Jan-IngenHousz-Institute/CO2Dot/Kicad/CO2Dot_v001/CO2Dot.png

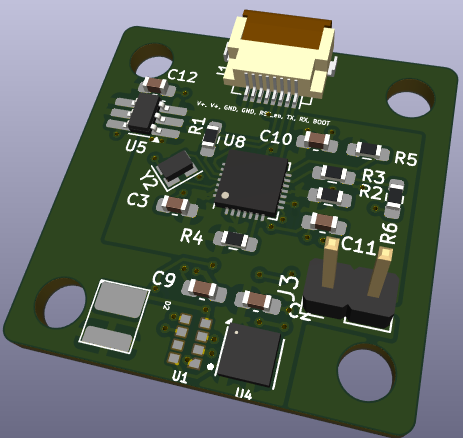
Kicad/CO2Dot_v001/CO2Dot.png
