Jan-IngenHousz-Institute/CO2Dot/Firmware/README.md

# firmware-CO2Dot
Repo for the firmware of the CO2Dot
