Jan-IngenHousz-Institute/CO2Dot/Scripts/Li-Control/README.md

This repository is a lightweight LI‑6800 control based on mqtt capability of the instrument.
