Jan-IngenHousz-Institute/CO2Dot/CAD/leaf_cells/chamber_CO2Dot_openExit.FCStd

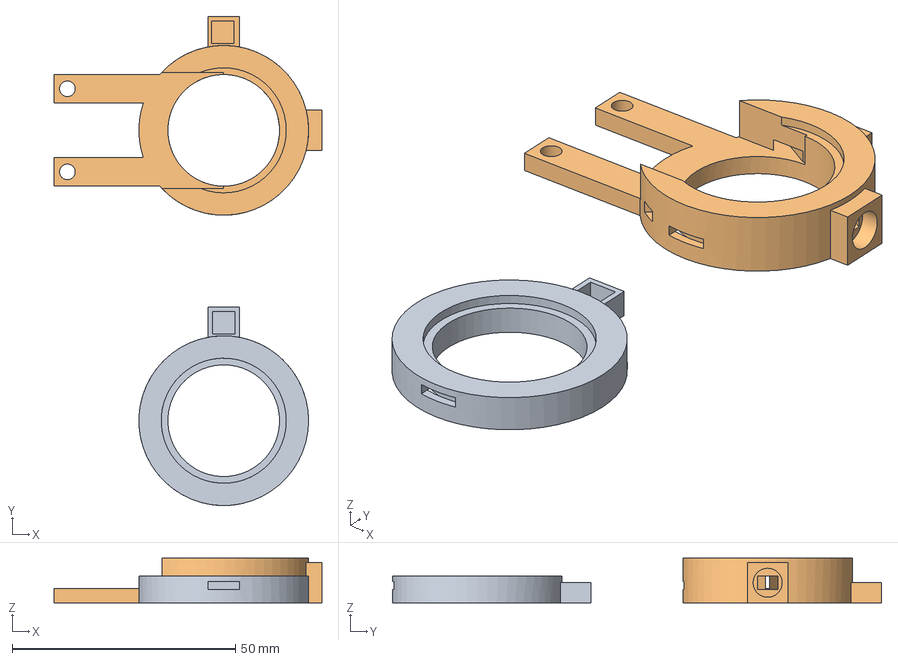
[picture p2: CAD file, 2026-07-20]
CAD/leaf_cells/chamber_CO2Dot_openExit.FCStd
60.0 x 109.5 x 10.0 mm
