Jan-IngenHousz-Institute/CO2Dot/CAD/Licor_cellAdapter.FCStd

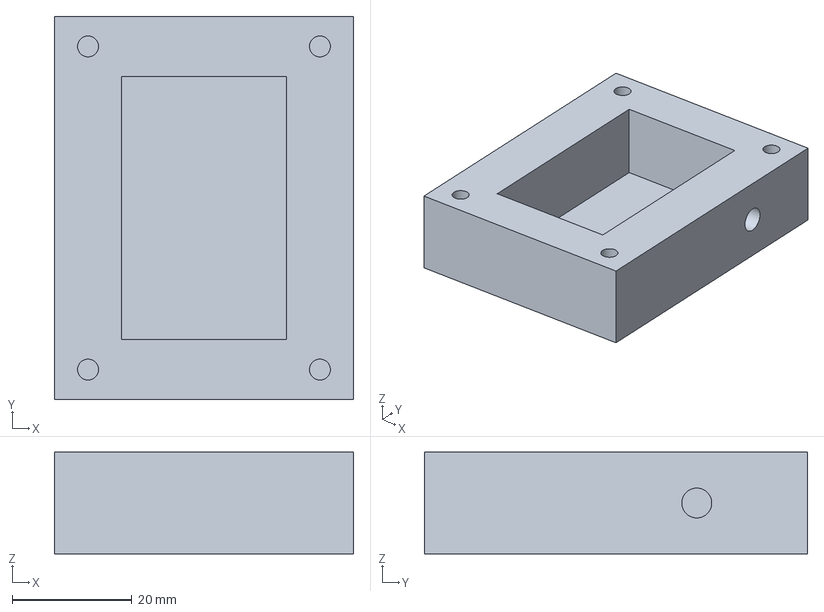
[picture p3: CAD file, 2026-11-12]
CAD/Licor_cellAdapter.FCStd
50.0 x 64.0 x 17.0 mm
