Jan-IngenHousz-Institute/CO2Dot/CAD/CO2Dot_holder_v003.FCStd

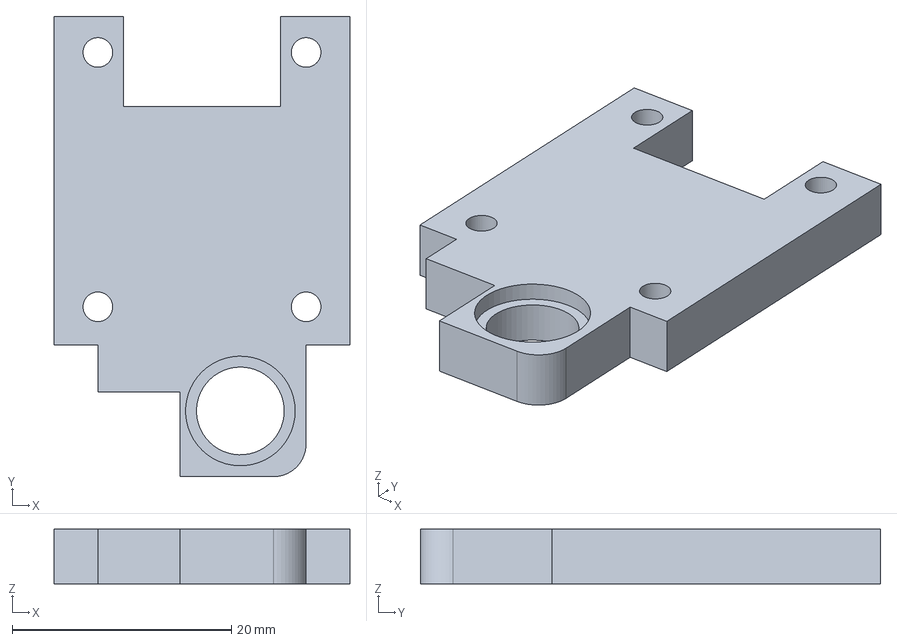
[picture p4: CAD file, 2026-10-07]
CAD/CO2Dot_holder_v003.FCStd
27.0 x 42.0 x 5.00 mm
