Jan-IngenHousz-Institute/CO2Dot/CAD/leaf_cells/chamber_CO2DOt_tubingExit.FCStd

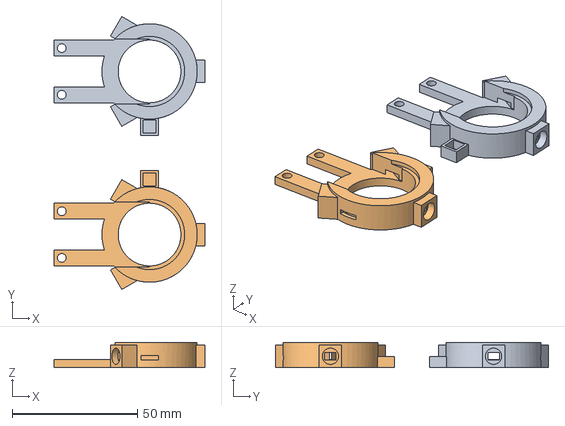
[picture p5: CAD file, 2026-07-20]
CAD/leaf_cells/chamber_CO2DOt_tubingExit.FCStd
60.0 x 108.8 x 10.0 mm
