Jan-IngenHousz-Institute/CO2Dot/CAD/CO2Dot_diffuserHolder.FCStd

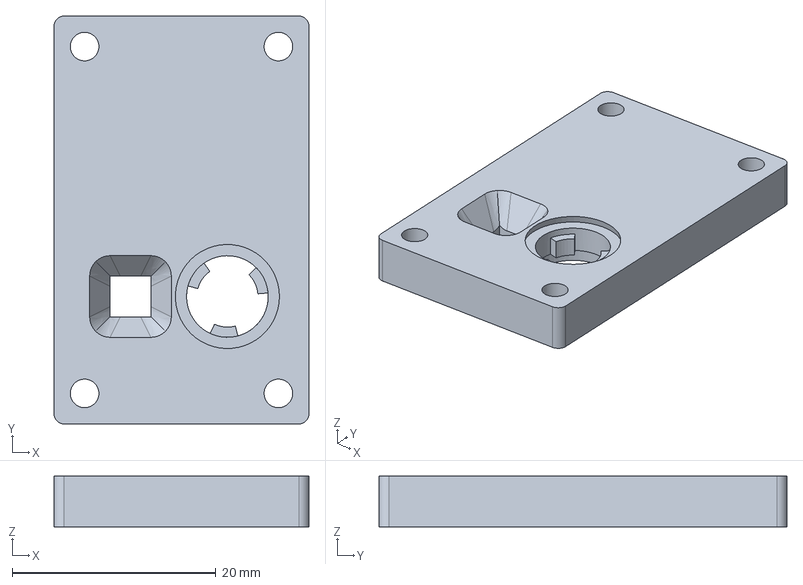
[picture p6: CAD file, 2026-06-19]
CAD/CO2Dot_diffuserHolder.FCStd
25.0 x 40.0 x 5.00 mm
