Jan-IngenHousz-Institute/CO2Dot/CAD/leaf_cells/CO2Dot_mask.3mf

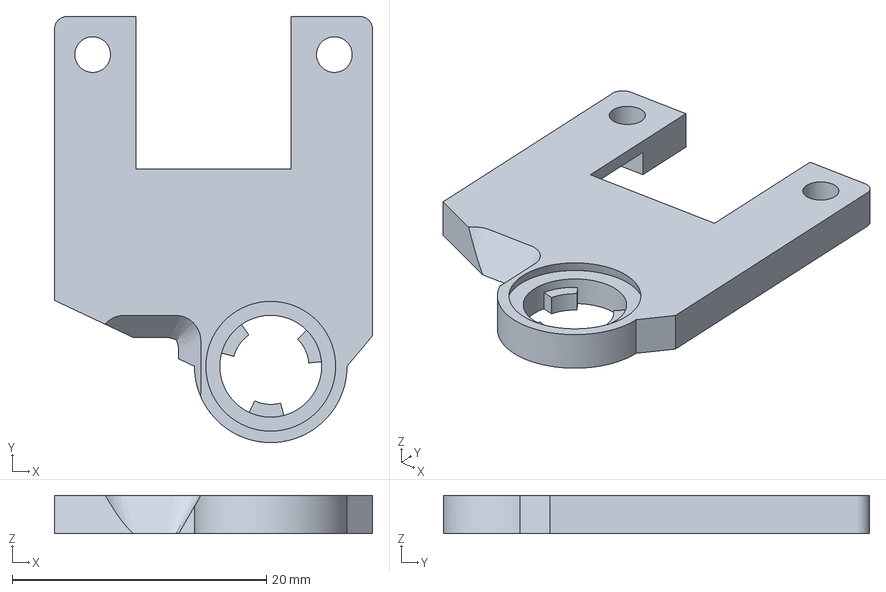
[picture p7: CAD file, 2026-07-20]
CAD/leaf_cells/CO2Dot_mask.3mf
25.0 x 33.5 x 3.00 mm
