Jan-IngenHousz-Institute/CO2Dot/CAD/gasCell_CO2Dot_v1.FCStd

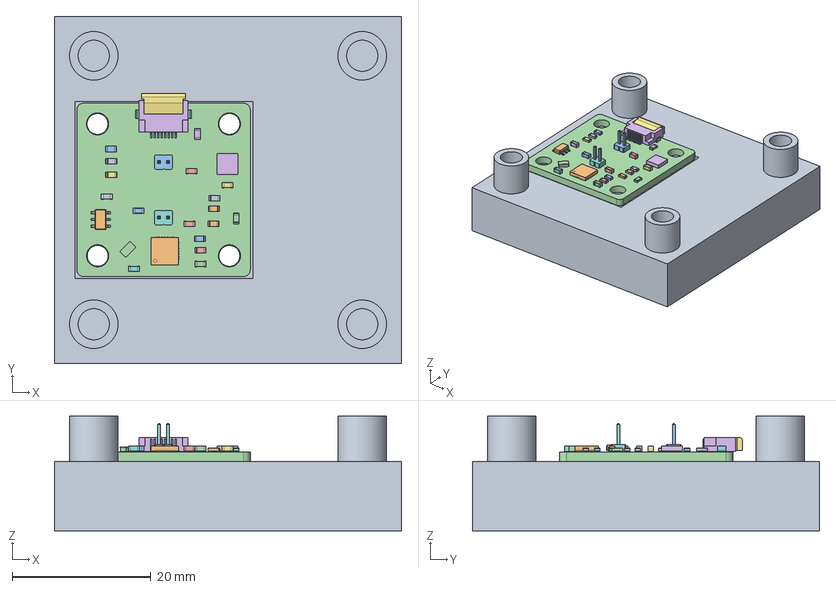
[picture p8: CAD file, 2026-05-03]
CAD/gasCell_CO2Dot_v1.FCStd
50.0 x 50.0 x 16.5 mm
CO2Dot_base
TSOT-23-6
R_0603_1608Metric
R_0603_1608Metric001
C_0603_1608Metric
R_0603_1608Metric002
R_0603_1608Metric003
C_0603_1608Metric001
C_0603_1608Metric002
QFN-28-1EP_4x4mm_P0.4mm_EP2.4x2.4mm
R_0603_1608Metric004
C_0603_1608Metric003
R_0603_1608Metric005
lock
pins
R_0603_1608Metric006
R_0603_1608Metric007
PinHeader_1x02_P1.27mm_Vertical
Crystal_SMD_MicroCrystal_CC8V-T1A-2Pin_2.0x1.2mm
C_0603_1608Metric004
Bosch_LGA-8_3x3mm_P0.8mm_ClockwisePinNumbering
C_0603_1608Metric005
PinHeader_1x02_P1.27mm_Vertical001
R_0603_1608Metric008
R_0603_1608Metric009
C_0603_1608Metric006
ambit_dyeCO2_PCB
