Jan-IngenHousz-Institute/CO2Dot/CAD/leaf_cells/mold_gasket.FCStd

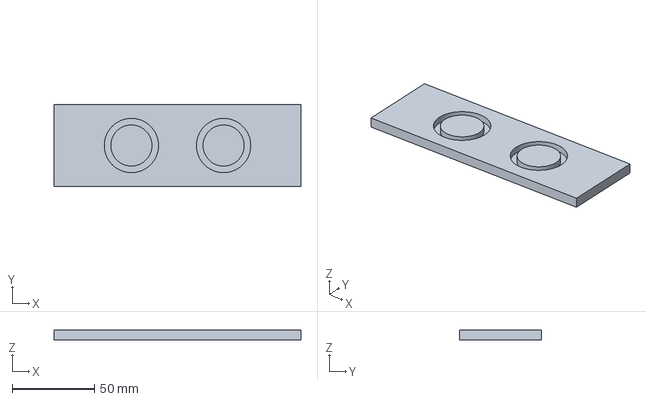
[picture p9: CAD file, 2026-07-20]
CAD/leaf_cells/mold_gasket.FCStd
150.0 x 50.0 x 6.00 mm
