Jan-IngenHousz-Institute/CO2Dot/CAD/leaf_cells/attachment_chamber_clip.FCStd

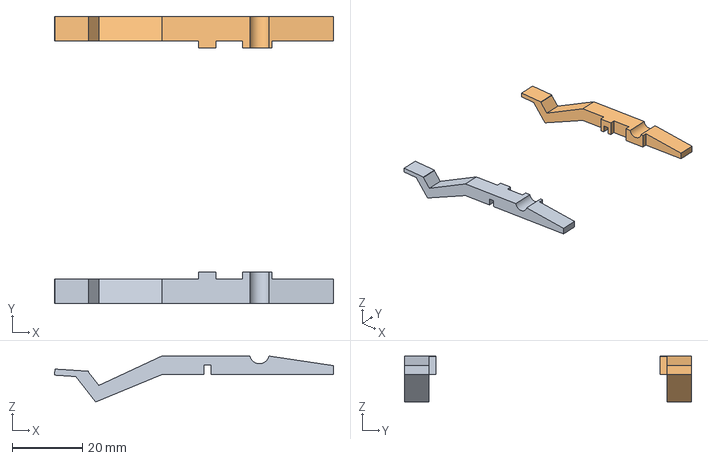
[picture p10: CAD file, 2026-07-20]
CAD/leaf_cells/attachment_chamber_clip.FCStd
79.6 x 82.0 x 13.1 mm
