Jan-IngenHousz-Institute/CO2Dot/(list of files, cad)

Other CAD files:
CAD/leaf_cells/CO2Dot_mask.stl
