Jan-IngenHousz-Institute/CO2Dot/Kicad/CO2Dot.kicad_pcb

## KiCad design Kicad/CO2Dot.kicad_pcb (2026-09-03)

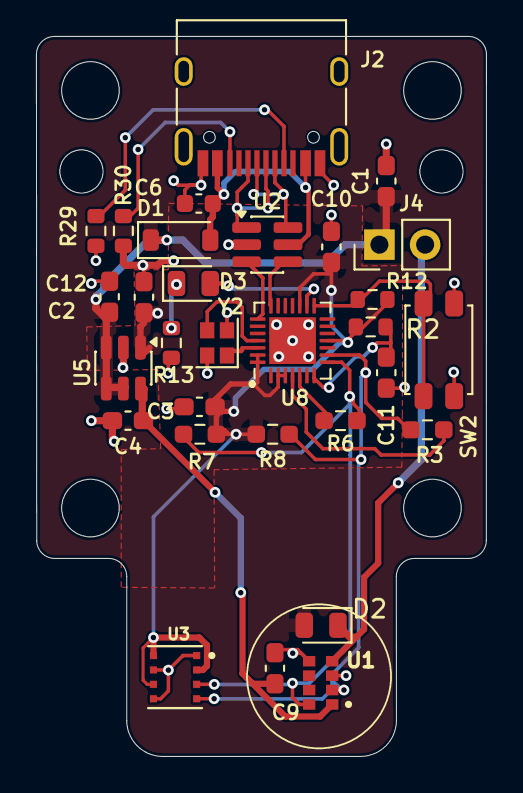
[picture p11: board Kicad/CO2Dot.kicad_pcb from above]

Board: 4 copper layers, 25.0 x 40.0 mm, 30 parts (0 on the bottom side), 22 nets.

Parts:
C1, C2, C3, C4, C9, C10, C11, C12: 2.2u; C_0603_1608Metric_Pad1.08x0.95mm_HandSolder
C6: 10u; C_0603_1608Metric
D1: 1N4148WT; D_SOD-123
D2, D3: LED; D_0805_2012Metric
J2: USB_C_Receptacle; USB_C_Receptacle_HRO_TYPE-C-31-M-12
J4: Conn_01x02_Pin; PinHeader_1x02_P2.54mm_Vertical
R2, R12, R13, R29, R30: 5.1K; R_0603_1608Metric
R3, R6: 0R; R_0603_1608Metric_Pad0.98x0.95mm_HandSolder
R7, R8: 10K; R_0603_1608Metric_Pad0.98x0.95mm_HandSolder
SW2: SW_Push; SW_SPST_EVQP2_ShortPushTravel_H2.1mm
U1: AS7341-DLGT; PSON80P310X200X110-8N
U2: IP4234CZ6; SC-74-6_1.55x2.9mm_P0.95mm
U3: BME688
U5: AP7312-1833W6-7; TSOT-23-6
U8: ESP8685; QFN-28-1EP_4x4mm_P0.4mm_EP2.6x2.6mm
Y2: 40MHz; Crystal_SMD_2016-4Pin_2.0x1.6mm

Connections:
BOOT: R12.1, SW2.1, U8.15 (GPIO9/BOOT)
CC1: J2.A5 (CC1), R29.2
CC2: J2.B5 (CC2), R30.2
D+: U2.3, U8.22 (GPIO19/USB_D+)
D-: U2.4, U8.21 (GPIO18/USB_D-)
GND: C1.2, C2.2, C3.2, C4.2, C6.1, C9.2, C10.2, C11.2, C12.2, J2.A1 (GND), J2.A12 (GND), J2.B1 (GND), J2.B12 (GND), J2.S1 (SHIELD), R13.1, R29.1, R30.1, SW2.2, U1.3 (GND), U1.5 (PGND), U2.2 (VN), U3.1 (GND), U3.5 (SDO), U3.7 (GND__1), U5.2 (GND), U8.29 (GND), Y2.2, Y2.4
LED1ACT: D2.1 (K), J4.2, U1.4 (LDR)
unnamed: D3.2 (A), U8.16 (GPIO10)
unnamed: D3.1 (K), R13.2
unnamed: J2.A6 (D+), J2.B6 (D+), U2.1
unnamed: J2.A7 (D-), J2.B7 (D-), U2.6
unnamed: U8.25 (XTAL_N), Y2.3
unnamed: U8.26 (XTAL_P), Y2.1
SCL: R3.2, R8.1, U1.2 (SCL), U3.4 (SCK), U8.9 (MTMS/GPIO4/ADC1_CH4)
SCL_2: R6.1, U8.5 (GPIO1/XTAL_32K_N/ADC1_CH1)
SDA: R6.2, R7.1, U1.8 (SDA), U3.3 (SDI), U8.8 (GPIO3/ADC1_CH3)
SDA_2: R3.1, U8.4 (GPIO0/XTAL_32K_P/ADC1_CH0)
V+: C1.1, C12.1, D1.1 (K), D2.2 (A), J4.1, U5.3 (EN2), U5.4 (EN1), U5.5 (VIN)
V+1.8V: C4.1, C9.1, U1.1 (VDD), U5.6 (VOUT_1V8)
V+3V: C2.1, C3.1, C10.1, R2.1, R7.2, R8.2, R12.2, U3.2 (CSB), U3.6 (VDDIO), U3.8 (VDD), U5.1 (VOUT_3V3), U8.2 (VDD3P3), U8.3 (VDD3P3), U8.11 (VDD3P3_RTC), U8.17 (VDD3P3_CPU), U8.27 (VDDA), U8.28 (VDDA)
Vusb: C6.2, D1.2 (A), J2.A4 (VBUS), J2.A9 (VBUS), J2.B4 (VBUS), J2.B9 (VBUS), U2.5 (VP)
reset_EN: C11.1, R2.2, U8.7 (CHIP_EN)
