Jan-IngenHousz-Institute/CO2Dot/Kicad/CO2Dot_v001/CO2Dot.kicad_pcb

## KiCad design Kicad/CO2Dot_v001/CO2Dot.kicad_pcb (2026-05-03)

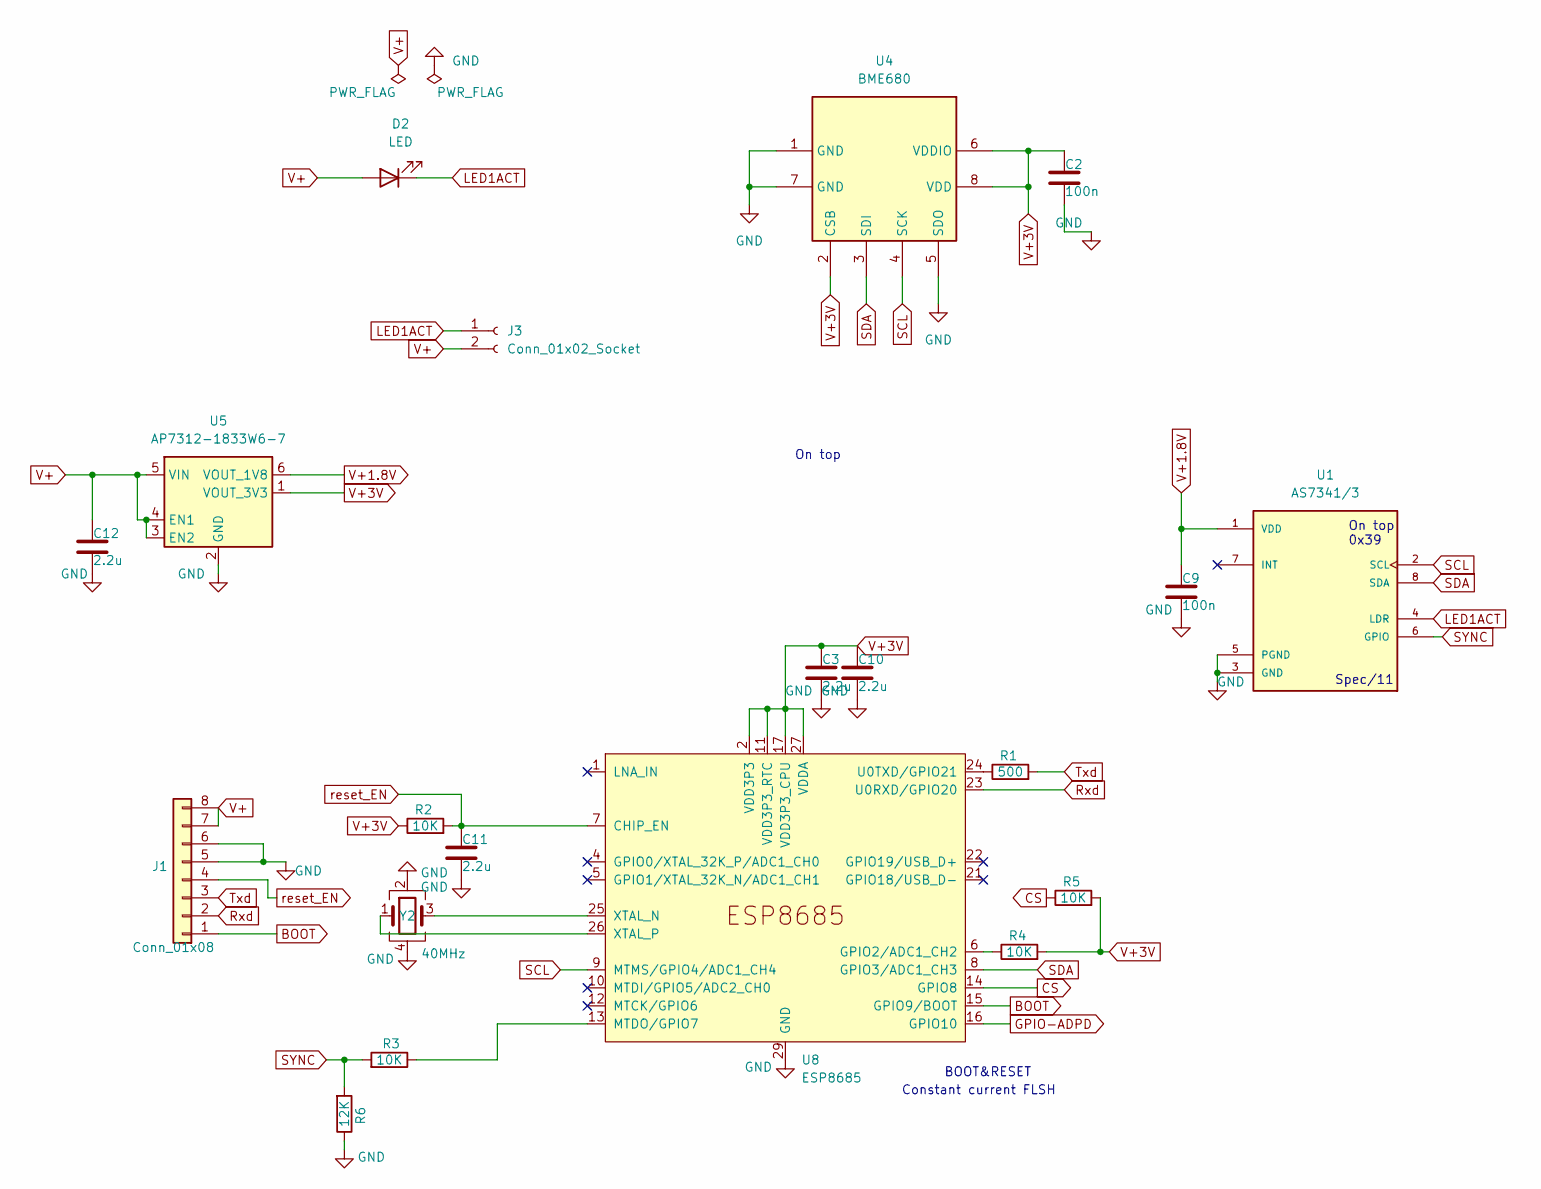
[picture p12: schematic CO2Dot.kicad_sch]

Parts:
C2, C9: 100n; C_0603_1608Metric_Pad1.08x0.95mm_HandSolder
C3, C10, C11, C12: 2.2u; C_0603_1608Metric_Pad1.08x0.95mm_HandSolder
D2: LED; NF2W757GT-F1
J1: Conn_01x08; Molex_5034800800_1x08-1MP_P0.50mm_Horizontal
J3: Conn_01x02_Socket; PinHeader_1x02_P2.54mm_Vertical
R1: 500; R_0603_1608Metric_Pad0.98x0.95mm_HandSolder
R2, R3, R4, R5: 10K; R_0603_1608Metric_Pad0.98x0.95mm_HandSolder
R6: 12K; R_0603_1608Metric_Pad0.98x0.95mm_HandSolder
U1: AS7341/3; XDCR_AS7341-DLGM; PARTREV V3
U4: BME680; Bosch_LGA-8_3x3mm_P0.8mm_ClockwisePinNumbering
U5: AP7312-1833W6-7; TSOT-23-6_HandSoldering
U8: ESP8685; QFN-28-1EP_4x4mm_P0.4mm_EP2.6x2.6mm
Y2: 40MHz; Crystal_SMD_2016-4Pin_2.0x1.6mm

Connections:
BOOT: J1.1, U8.15 (GPIO9/BOOT)
CS: R5.1, U8.14 (GPIO8)
GND: C2.2, C3.2, C9.2, C10.2, C11.2, C12.2, J1.5, J1.6, R6.1, U1.3 (GND), U1.5 (PGND), U4.1 (GND), U4.5 (SDO), U4.7 (GND), U5.2 (GND), U8.29 (GND), Y2.2, Y2.4
GPIO-ADPD: U8.16 (GPIO10)
LED1ACT: D2.1 (K), J3.1, U1.4 (LDR)
unnamed: R4.1, U8.6 (GPIO2/ADC1_CH2)
unnamed: R3.1, U8.13 (MTDO/GPIO7)
unnamed: R1.1, U8.24 (U0TXD/GPIO21)
unnamed: U8.25 (XTAL_N), Y2.3
unnamed: U8.26 (XTAL_P), Y2.1
Rxd: J1.2, U8.23 (U0RXD/GPIO20)
SCL: U1.2 (SCL), U4.4 (SCK), U8.9 (MTMS/GPIO4/ADC1_CH4)
SDA: U1.8 (SDA), U4.3 (SDI), U8.8 (GPIO3/ADC1_CH3)
SYNC: R3.2, R6.2, U1.6 (GPIO)
Txd: J1.3, R1.2
V+: C12.1, D2.2 (A), J1.7, J1.8, J3.2, U5.3 (EN2), U5.4 (EN1), U5.5 (VIN)
V+1.8V: C9.1, U1.1 (VDD), U5.6 (VOUT_1V8)
V+3V: C2.1, C3.1, C10.1, R2.1, R4.2, R5.2, U4.2 (CSB), U4.6 (VDDIO), U4.8 (VDD), U5.1 (VOUT_3V3), U8.2 (VDD3P3), U8.3 (VDD3P3), U8.11 (VDD3P3_RTC), U8.17 (VDD3P3_CPU), U8.27 (VDDA), U8.28 (VDDA)
reset_EN: C11.1, J1.4, R2.2, U8.7 (CHIP_EN)

Notes on the sheet:
Spec/11
On top
BOOT&RESET
On top 0x39
Constant current FLSH

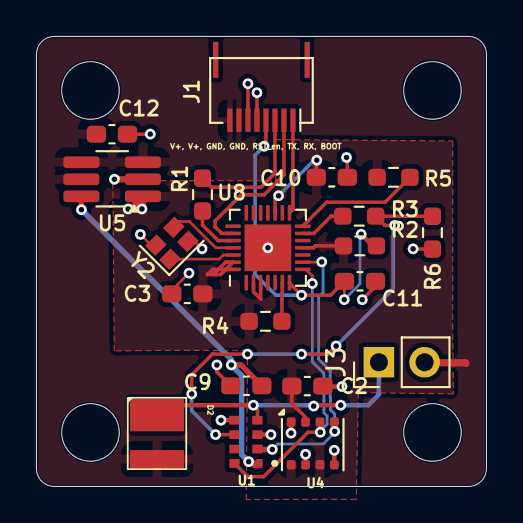
[picture p13: board Kicad/CO2Dot_v001/CO2Dot.kicad_pcb from above]

Board: 4 copper layers, 25.0 x 25.0 mm, 20 parts (0 on the bottom side), 18 nets.
