Jan-IngenHousz-Institute/CO2Dot/Firmware/gui/li_discovery.py

"""
li_discovery.py — zeroconf-based mDNS browser for Li-6800 discovery.

Imports `zeroconf` at module top so that a missing package raises ImportError
at `from li_discovery import LiDiscovery` time (caught on the main thread in
_init_li_control / _on_li_scan), not later on a worker thread.

If zeroconf is missing, callers fall back to li_discovery_plain.PlainMdnsResolver
directly. Both classes duck-type the same interface:
    host_found = Signal(str, str)
    finished   = Signal(int)
    start(duration_s: float) -> None
    stop() -> None
"""

from __future__ import annotations

from PySide6.QtCore import QObject, QTimer, Signal

from zeroconf import ServiceBrowser, ServiceStateChange, Zeroconf

from li_discovery_plain import PlainMdnsResolver

LICOR_SERVICE_TYPES = (
    "_ssh._tcp.local.",
    "_sftp-ssh._tcp.local.",
    "_http._tcp.local.",
    "_workstation._tcp.local.",
)

LICOR_NAME_HINTS = ("licor", "li-6800", "li6800")


def _looks_like_licor(name: str) -> bool:
    low = name.lower()
    return any(hint in low for hint in LICOR_NAME_HINTS)


class LiDiscovery(QObject):
    host_found = Signal(str, str)
    finished = Signal(int)

    def __init__(self, parent: QObject | None = None) -> None:
        super().__init__(parent)
        self._zc: Zeroconf | None = None
        self._browsers: list[ServiceBrowser] = []
        self._plain = PlainMdnsResolver(self)
        self._plain.host_found.connect(self._relay_host)
        self._plain.finished.connect(self._on_plain_finished)
        self._stop_timer = QTimer(self)
        self._stop_timer.setSingleShot(True)
        self._stop_timer.timeout.connect(self._on_stop_timer)
        self._seen: set[str] = set()
        self._running = False
        self._plain_done = False
        self._zeroconf_done = False

    def start(self, duration_s: float = 5.0) -> None:
        if self._running:
            return
        self._running = True
        self._seen.clear()
        self._plain_done = False
        self._zeroconf_done = False

        # Plain resolver path (stdlib mDNS)
        self._plain.start(duration_s)
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
