Jan-IngenHousz-Institute/CO2Dot/(commit log)

2026-05-03 initial comit
    [gasCell_CO2Dot_v1.FCStd]
2026-05-06 PCB CO2Dot with BME, V002 (squashed)
    [CO2Dot.kicad_pcb, CO2Dot.kicad_sch, pyvenv.cfg]
2026-05-06 Re-track .gitignore (self-exception)
2026-05-06 PCB CO2Dot with BME, V002
2026-05-07 platformIO usb or uart option
2026-06-19 Apply updated .gitignore (untrack now-ignored files)
    [CO2Dot.kicad_pcb, CO2Dot_diffuserHolder.FCStd]
2026-06-19 fixed iterate temperature script
2026-06-30 RH fix in li_mqtt.py
    [li_mqtt.py]
2026-07-20 added Paul CADfiles
    [CO2Dot_diffuserHolder.FCStd, CO2Dot_mask.3mf, attachment_chamber_clip.FCStd, chamber_CO2DOt_tubingExit.FCStd, chamber_CO2Dot_openExit.FCStd, gasCell_CO2Dot_v1.FCStd, li6400_log.csv, mold_gasket.FCStd]
2026-08-14 (kicad) fixed unconnected
    [CO2Dot.kicad_pcb, data_test_spectro_as_PAM.csv]
2026-08-14 (kicad) board rev 0.0.1
    [CO2Dot.kicad_pcb]
2026-09-03 (kicad-freeCAD) CO2 v0.0.3
    [CO2Dot.kicad_pcb, CO2Dot_PCB_v003.step, CO2Dot_holder_v003.FCStd, CO2Dot_mask.stl]
